feket663/raspiradio/Images/Audio_bord.jpg

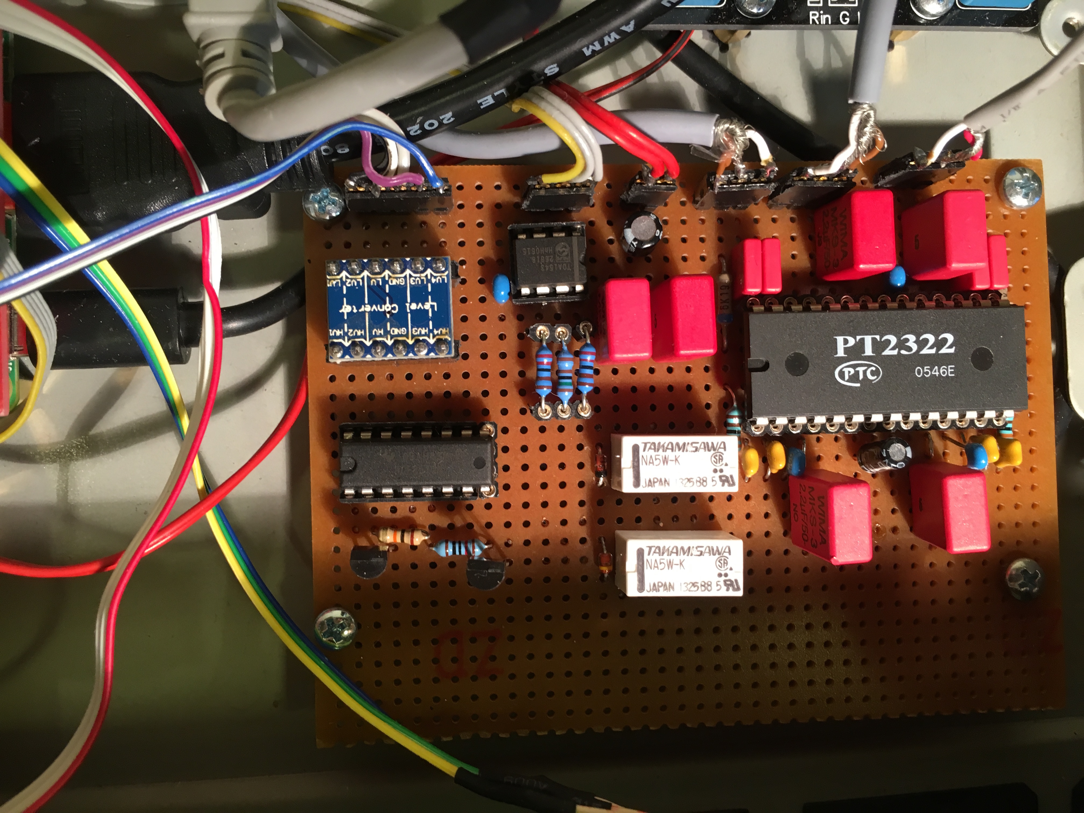
Images/Audio_bord.jpg
