feket663/raspiradio/Images/Client_open_back.jpg

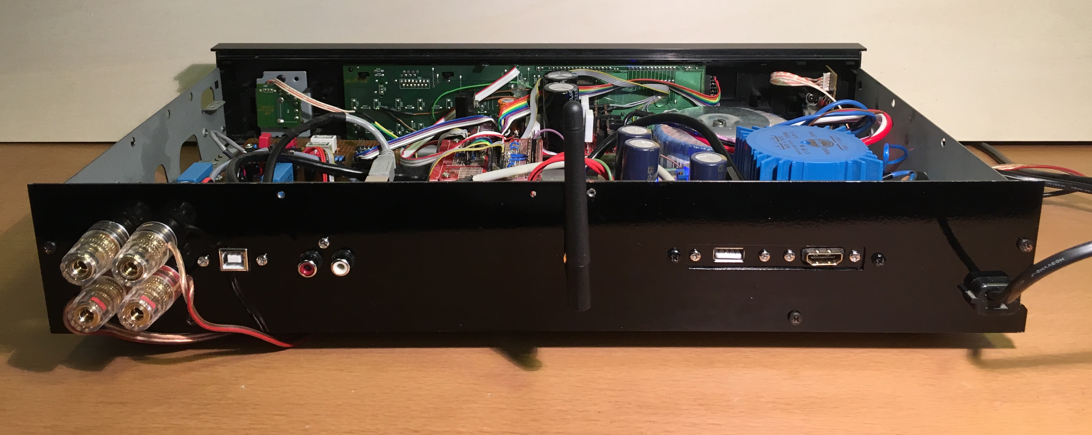
Images/Client_open_back.jpg
