feket663/raspiradio/Images/Client_open_front.jpg

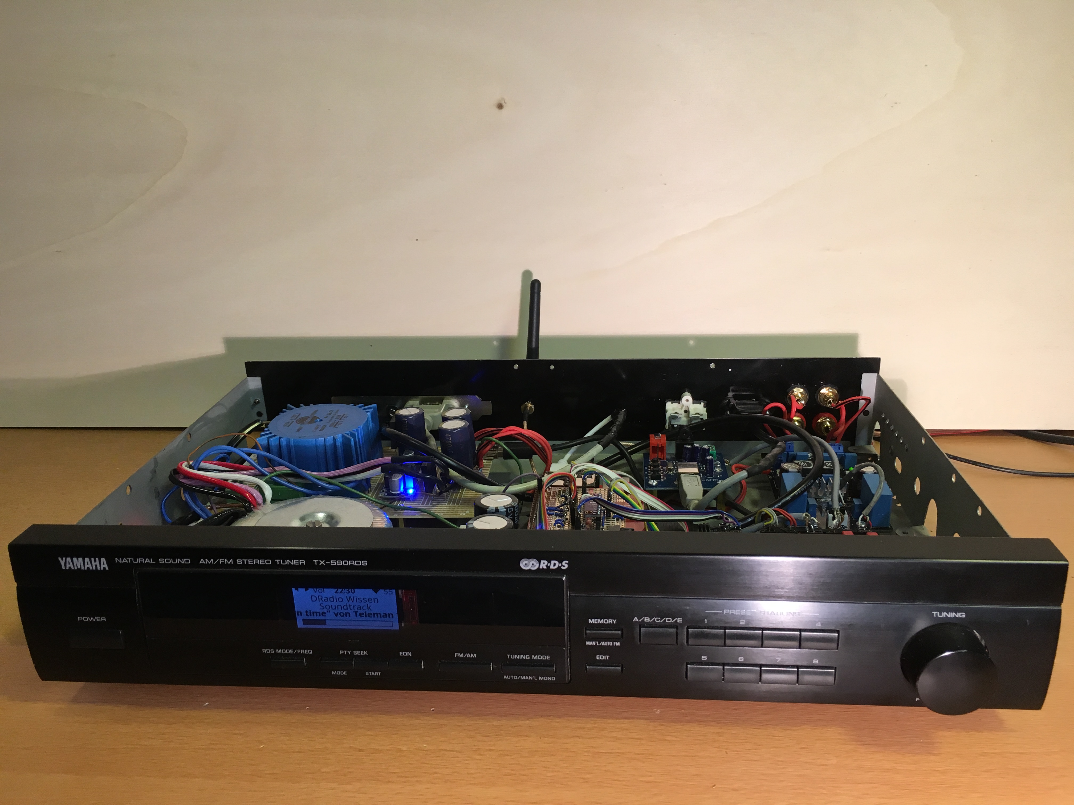
Images/Client_open_front.jpg
