feket663/raspiradio/Images/Client_open_top.jpg

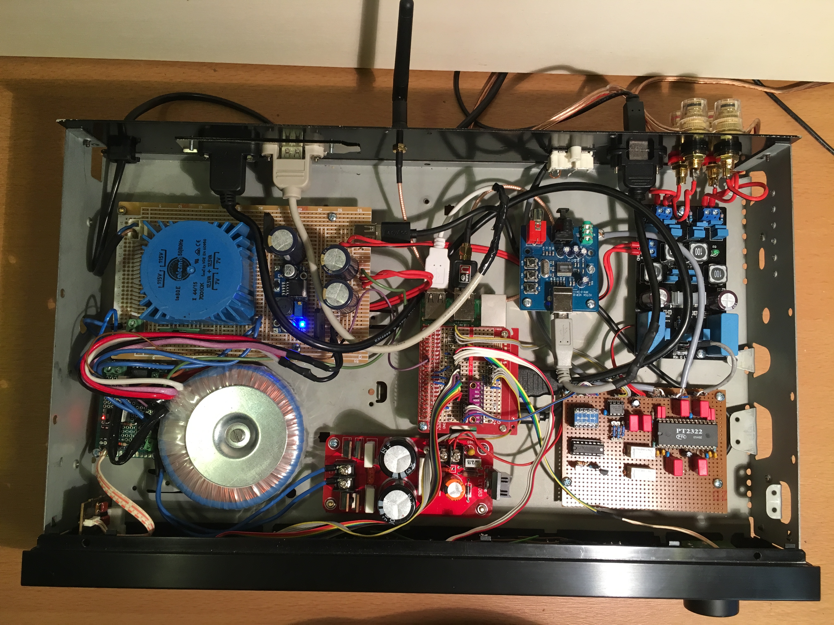
Images/Client_open_top.jpg
