feket663/raspiradio/Images/Client_without_speaker.jpg

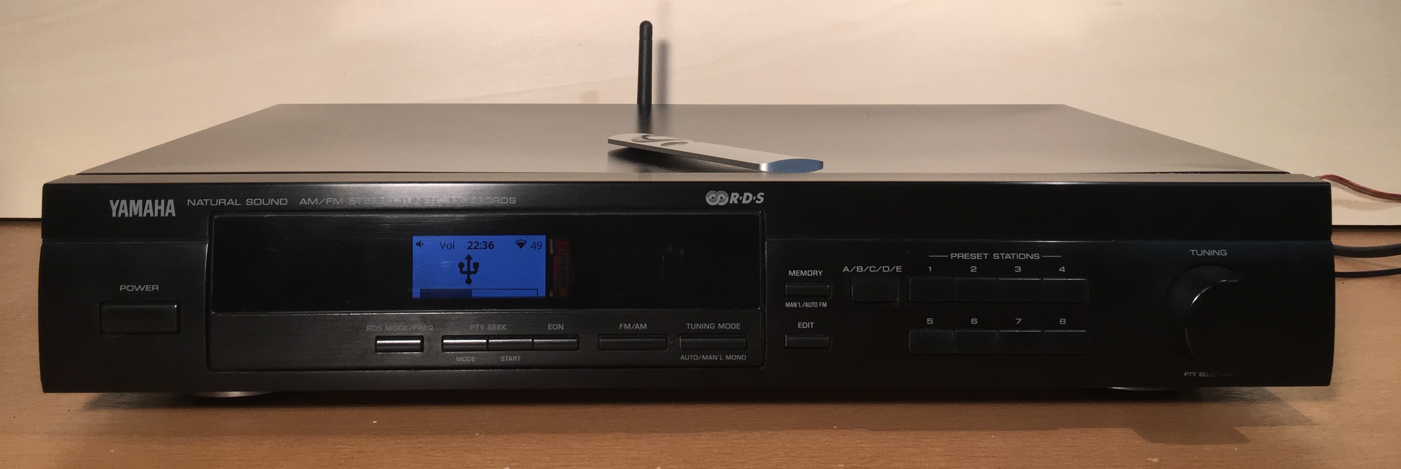
Images/Client_without_speaker.jpg
