feket663/raspiradio/Images/LOW-Noise-Power.jpeg

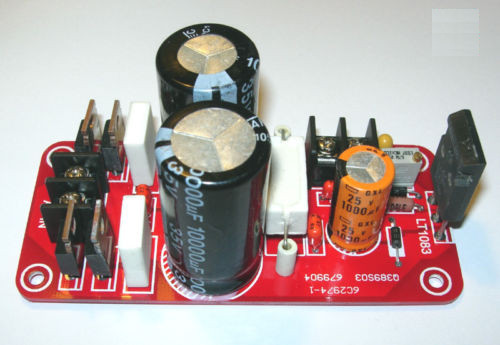
Images/LOW-Noise-Power.jpeg
