feket663/raspiradio/Images/low-power-schematics.jpeg

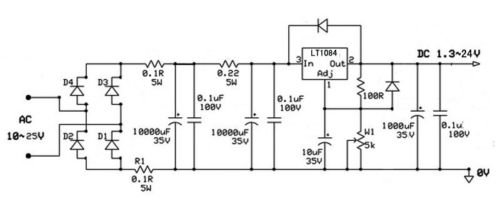
Images/low-power-schematics.jpeg
