feket663/raspiradio/Images/pcm2704_usb.jpg

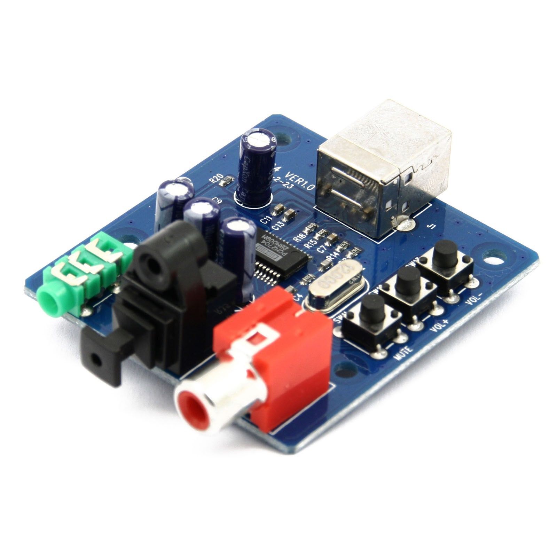
Images/pcm2704_usb.jpg
