feket663/raspiradio/Images/Power_control_board.jpg

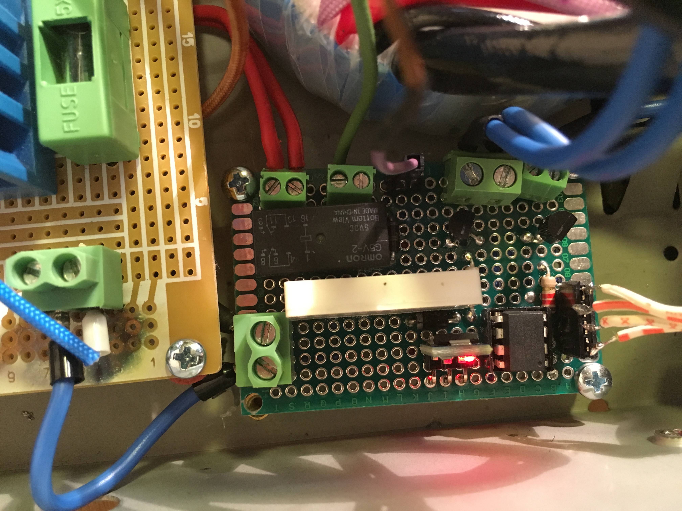
Images/Power_control_board.jpg
