feket663/raspiradio/Images/speaker_terminal.jpg

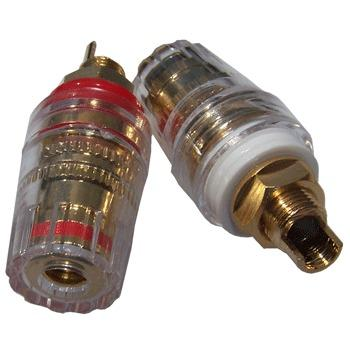
Images/speaker_terminal.jpg
