feket663/raspiradio/Images/TPA3116.jpg

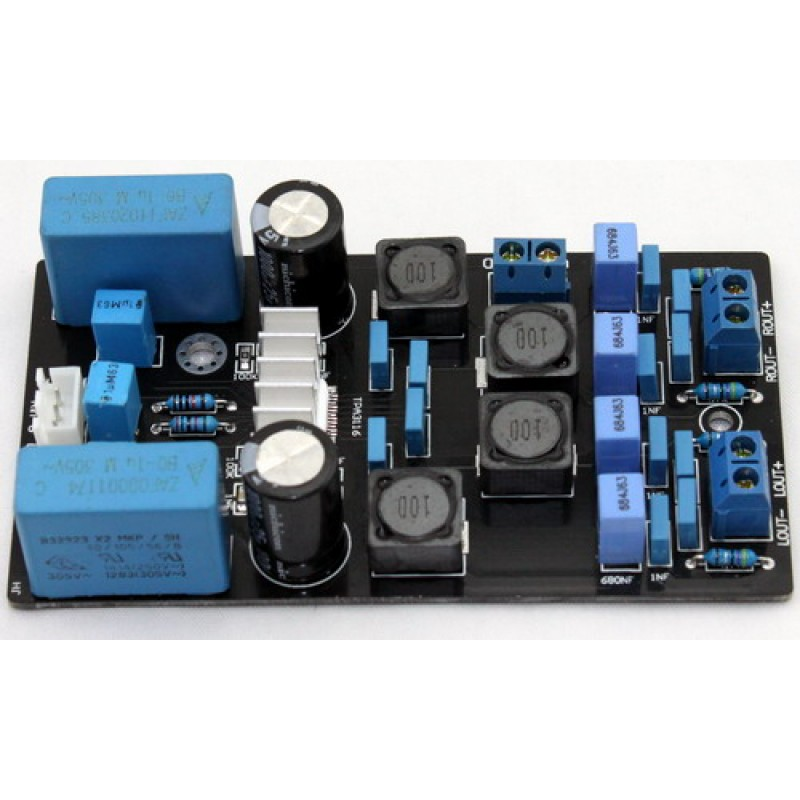
Images/TPA3116.jpg
