feket663/raspiradio/schematics/audio-board.png

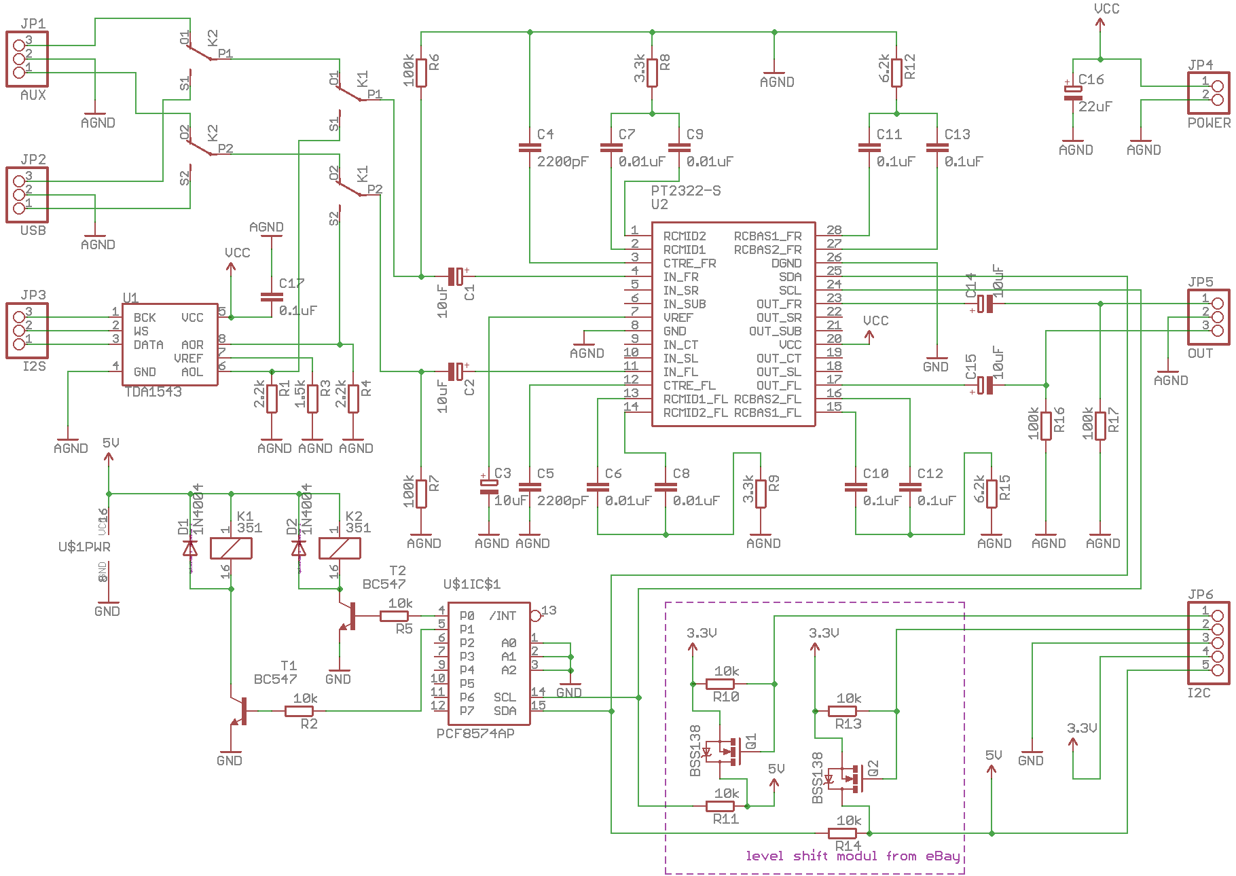
schematics/audio-board.png
