feket663/raspiradio/schematics/power-control-board.png

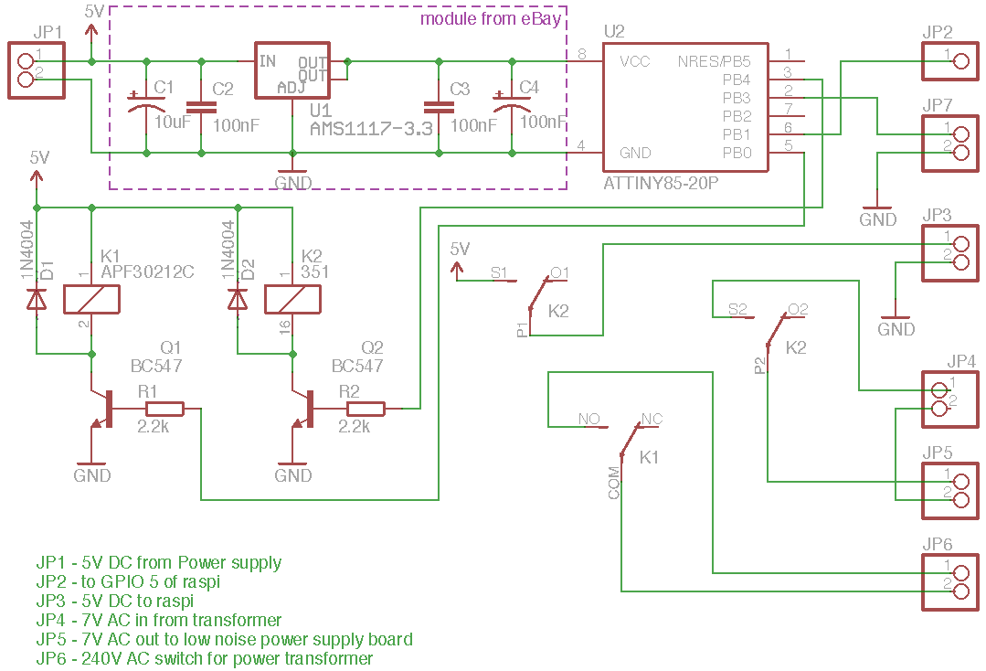
schematics/power-control-board.png
