feket663/raspiradio/schematics/audio-board.sch

## EAGLE design schematics/audio-board.sch (2016-09-04)

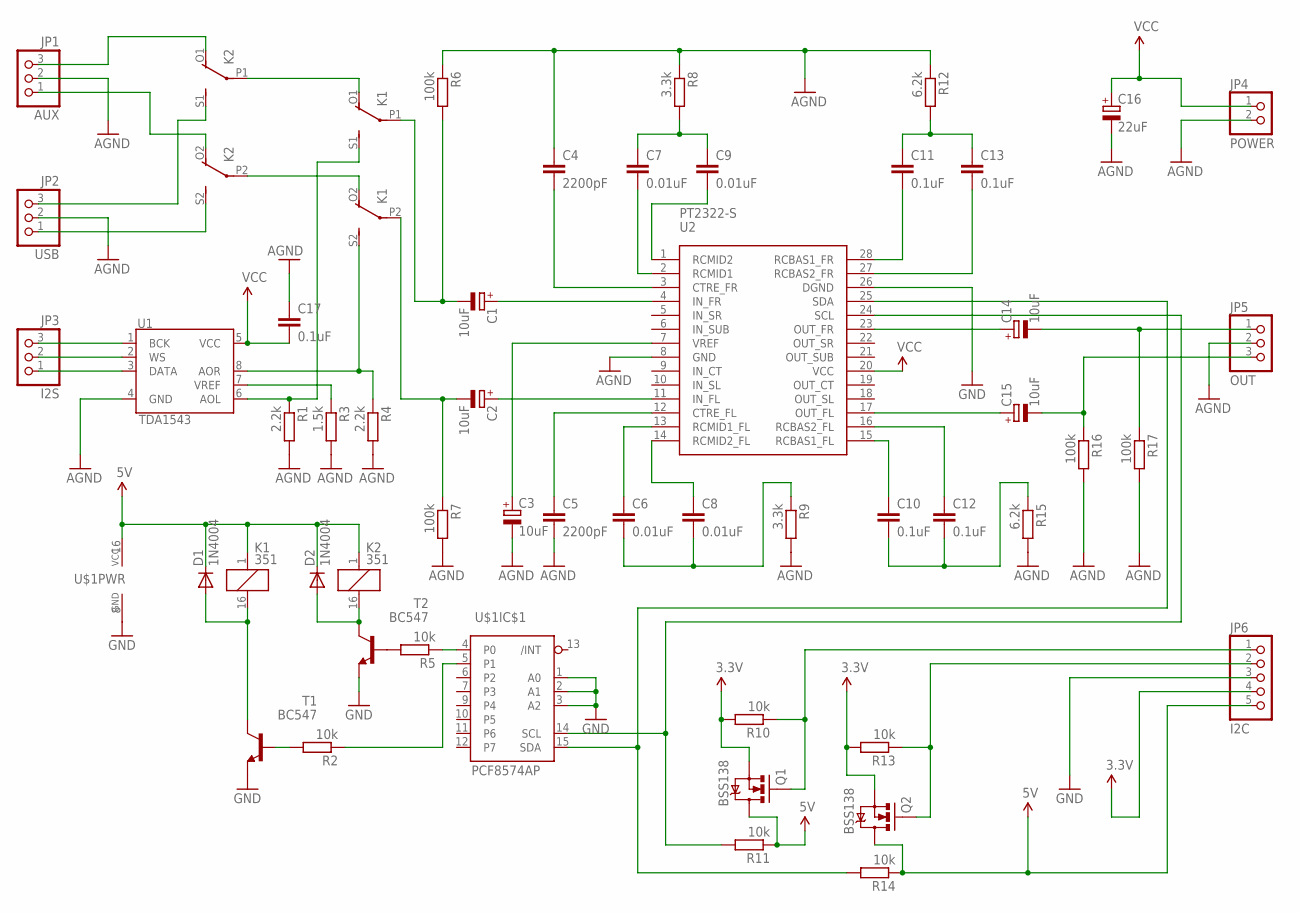
[picture p27: schematic audio-board.sch]

Parts:
AUX: JP1; 1X03
C1, C2, C3, C14, C15: 10uF; E2-5
C4, C5: 2200pF; C025-025X050
C6, C7, C8, C9: 0.01uF; C025-025X050
C10, C11, C12, C13, C17: 0.1uF; C025-025X050
C16: 22uF; E2,5-7
D1, D2: 1N4004; DO41-10
I2S: JP3; 1X03
JP4: POWER; 1X02
JP5: OUT; 1X03
JP6: I2C; 1X05
K1, K2: 351
Q1, Q2: BSS138; SOT23-3
R1, R4: 2.2k; 0207/10
R2, R5, R10, R11, R13, R14: 10k; 0207/10
R3: 1.5k; 0207/10
R6, R7, R16, R17: 100k; 0207/10
R8, R9: 3.3k; 0207/10
R12, R15: 6.2k; 0207/10
T1, T2: BC547; TO92
U1: TDA1543; DIL8
U2: PT2322-S; SOP28
U$1: PCF8574AP; DIL16
USB: JP2; 1X03

Connections:
3.3V: JP6.4, Q1.2 (S), Q2.2 (S), R10.2, R13.2
5V: D1.C, D2.C, JP6.5, K1.1, K2.1, Q1.3 (D), Q2.3 (D), R11.1, R14.1, U$1.16 (VCC)
AGND: AUX.2, C3.-, C4.1, C5.2, C16.-, C17.1, JP4.2, JP5.2, R1.2, R3.2, R4.2, R6.1, R7.2, R8.1, R9.2, R12.1, R15.2, R16.2, R17.2, U1.4 (GND), U2.8 (GND), USB.2
GND: JP6.3, T1.1 (E), T2.1 (E), U2.26 (DGND), U$1.1 (A0), U$1.2 (A1), U$1.3 (A2), U$1.8 (GND)
unnamed: C1.+, U2.4 (IN_FR)
unnamed: C2.+, U2.11 (IN_FL)
unnamed: C1.-, K1.P1, R6.2
unnamed: C2.-, K1.P2, R7.1
unnamed: C3.+, U2.7 (VREF)
unnamed: C5.1, U2.12 (CTRE_FL)
unnamed: C6.1, U2.13 (RCMID1_FL)
unnamed: C8.1, U2.14 (RCMID2_FL)
unnamed: C10.2, C12.2, R15.1
unnamed: C12.1, U2.16 (RCBAS2_FL)
unnamed: C10.1, U2.15 (RCBAS1_FL)
unnamed: K1.O1 (O), K2.P1
unnamed: C9.2, U2.1 (RCMID2)
unnamed: C7.2, U2.2 (RCMID1)
unnamed: C4.2, U2.3 (CTRE_FR)
unnamed: C7.1, C9.1, R8.2
unnamed: AUX.3, K2.O1 (O)
unnamed: C11.2, U2.28 (RCBAS1_FR)
unnamed: C13.2, U2.27 (RCBAS2_FR)
unnamed: C11.1, C13.1, R12.2
unnamed: C14.+, U2.23 (OUT_FR)
unnamed: C15.+, U2.17 (OUT_FL)
unnamed: C14.-, JP5.1, R17.1
unnamed: C15.-, JP5.3, R16.1
unnamed: AUX.1, K2.O2 (O)
unnamed: K2.S1 (S), USB.3
unnamed: K2.S2 (S), USB.1
unnamed: I2S.3, U1.1 (BCK)
unnamed: I2S.2, U1.2 (WS)
unnamed: I2S.1, U1.3 (DATA)
unnamed: K1.O2 (O), K2.P2
unnamed: D1.A, K1.16 (2), T1.3 (C)
unnamed: K1.S2 (S), R4.1, U1.8 (AOR)
unnamed: C6.2, C8.2, R9.1
unnamed: K1.S1 (S), R1.1, U1.6 (AOL)
unnamed: R3.1, U1.7 (VREF)
unnamed: D2.A, K2.16 (2), T2.3 (C)
unnamed: R5.2, T2.2 (B)
unnamed: R2.2, T1.2 (B)
unnamed: R11.2, U2.24 (SCL), U$1.14 (SCL)
unnamed: R14.2, U2.25 (SDA), U$1.15 (SDA)
unnamed: JP6.2, Q2.1 (G), R13.1
unnamed: JP6.1, Q1.1 (G), R10.1
U2: R5.1, U$1.4 (P0)
U3: R2.1, U$1.5 (P1)
VCC: C16.+, C17.2, JP4.1, U1.5 (VCC), U2.20 (VCC)
