feket663/raspiradio/schematics/power-control-board.sch

## EAGLE design schematics/power-control-board.sch (2016-09-01)

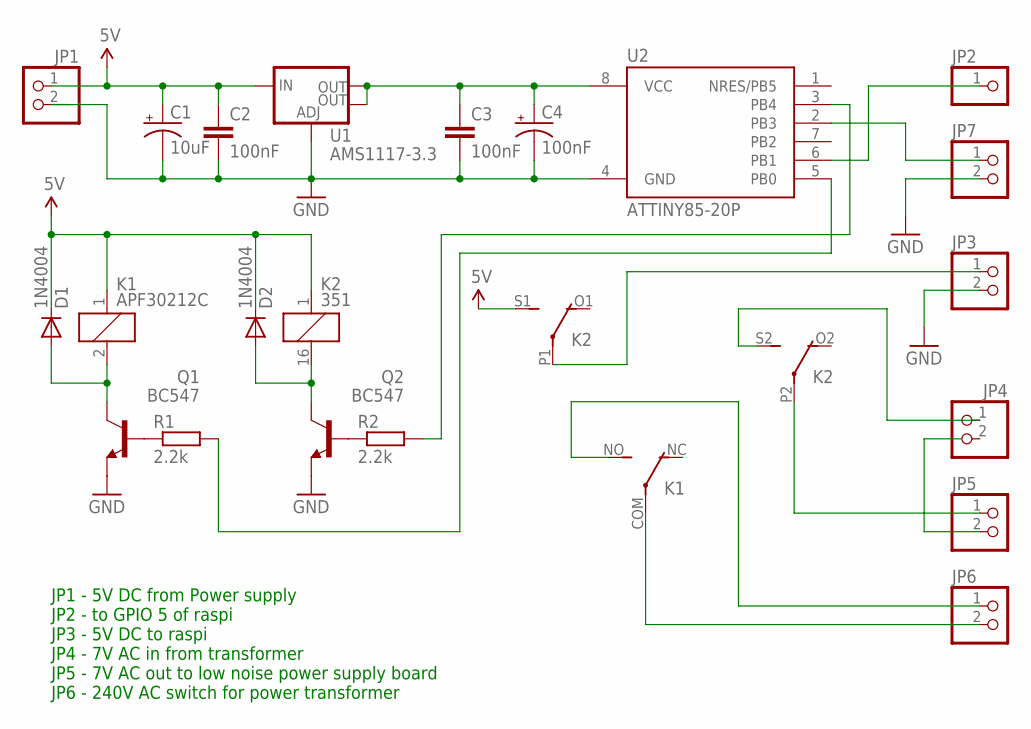
[picture p28: schematic power-control-board.sch]

Parts:
C1: 10uF; CPOL-RADIAL-10UF-25V-KIT
C2, C3: 100nF; 0402-CAP
C4: 100nF; CPOL-RADIAL-10UF-25V-KIT
D1, D2: 1N4004; DO41-10
JP1, JP3, JP4, JP5, JP6, JP7: PINHD-1X2; 1X02
JP2: PINHD-1X1; 1X01
K1: APF30212C
K2: 351
Q1, Q2: BC547; TO92
R1, R2: 2.2k; 0204/7
U1: AMS1117-3.3; SOT223
U2: ATTINY85-20P; PDIP08_300MIL

Connections:
5V: C1.1 (+), C2.1, D1.C, D2.C, JP1.1, K1.1, K2.1, K2.S1 (S), U1.3 (IN)
GND: C1.2 (-), C2.2, C3.2, C4.2 (-), JP1.2, JP3.2, JP7.2, Q1.1 (E), Q2.1 (E), U1.1 (ADJ), U2.4 (GND)
unnamed: Q1.2 (B), R1.1
unnamed: R1.2, U2.5 (PB0)
unnamed: R2.2, U2.3 (PB4)
unnamed: C3.1, C4.1 (+), U1.2 (OUT), U1.4 (OUT), U2.8 (VCC)
unnamed: D1.A, K1.2, Q1.3 (C)
unnamed: JP2.1, U2.6 (PB1)
unnamed: JP3.1, K2.P1
unnamed: Q2.2 (B), R2.1
unnamed: D2.A, K2.16 (2), Q2.3 (C)
unnamed: JP4.1, K2.S2 (S)
unnamed: JP5.1, K2.P2
unnamed: JP6.1, K1.NO (S)
unnamed: JP6.2, K1.COM
unnamed: JP7.1, U2.2 (PB3)

Notes on the sheet:
JP1 - 5V DC from Power supply JP2 - to GPIO 5 of raspi JP3 - 5V DC to raspi JP4 - 7V AC in from transformer JP5 - 7V AC out to low noise power supply board JP6 - 240V AC switch for power transformer
