feket663/raspiradio/schematics/power-supply-board.sch

## EAGLE design schematics/power-supply-board.sch (2016-09-01)

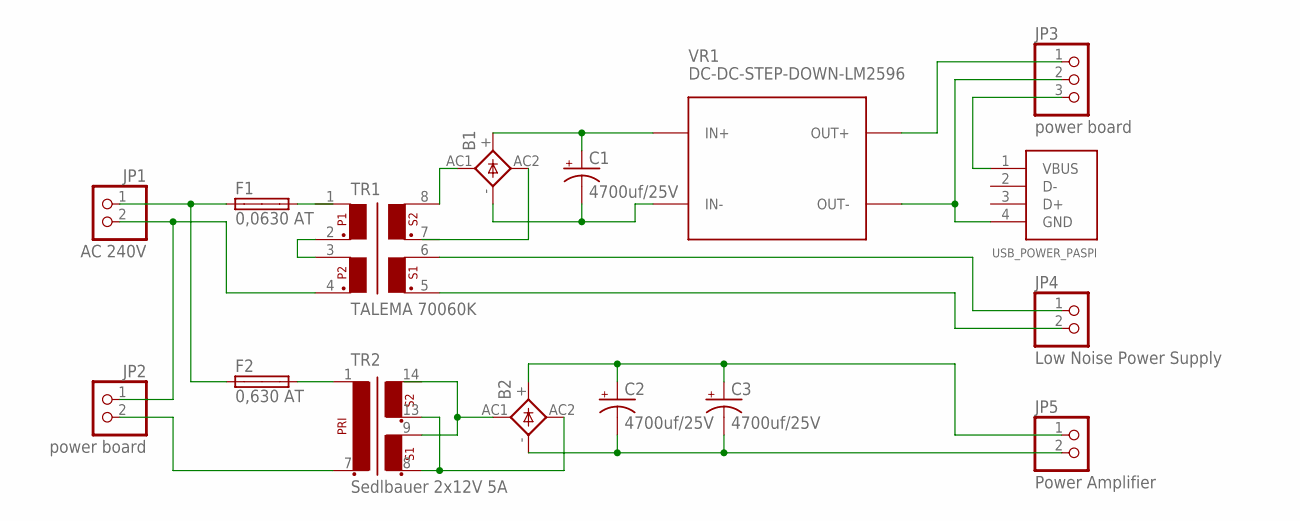
[picture p29: schematic power-supply-board.sch]

Parts:
B1, B2: KBU
C1, C2, C3: 4700uf/25V; CPOL-RADIAL-1000UF-25V-KIT
F1: 0,0630 AT; SHK20L
F2: 0,630 AT; SHK20L
JP1: AC 240V; 1X02
JP2: power board; 1X02
JP3: power board; 1X03
JP4: Low Noise Power Supply; 1X02
JP5: Power Amplifier; 1X02
TR1: TALEMA 70060K; FL10-30
TR2: Sedlbauer 2x12V 5A; EI54-18,8_16VA
USB_POWER_PASPI: USB POWER RASPI; USB-MALE-A-PCB
VR1: DC-DC-STEP-DOWN-LM2596

Connections:
unnamed: F2.2A, TR2.1
unnamed: TR1.2, TR1.3
unnamed: B2.AC2, TR2.8 (3), TR2.13 (5)
unnamed: B2.AC1, TR2.9 (4)
unnamed: B1.AC1, TR1.8
unnamed: B1.+, C1.+, VR1.IN+
unnamed: B1.-, C1.-, VR1.IN-
unnamed: JP3.1, VR1.OUT+
unnamed: JP4.1, TR1.6
unnamed: JP4.2, TR1.5
unnamed: JP3.2, USB_POWER_PASPI.4 (GND), VR1.OUT-
unnamed: F1.1A, F2.1A, JP1.1
unnamed: JP3.3, USB_POWER_PASPI.1 (VBUS)
unnamed: JP1.2, JP2.1, TR1.4
unnamed: B2.+, C2.+, C3.+, JP5.1
unnamed: B2.-, C2.-, C3.-, JP5.2
unnamed: JP2.2, TR2.7 (2)
