feket663/raspiradio/Images/Power_supply_board.jpg

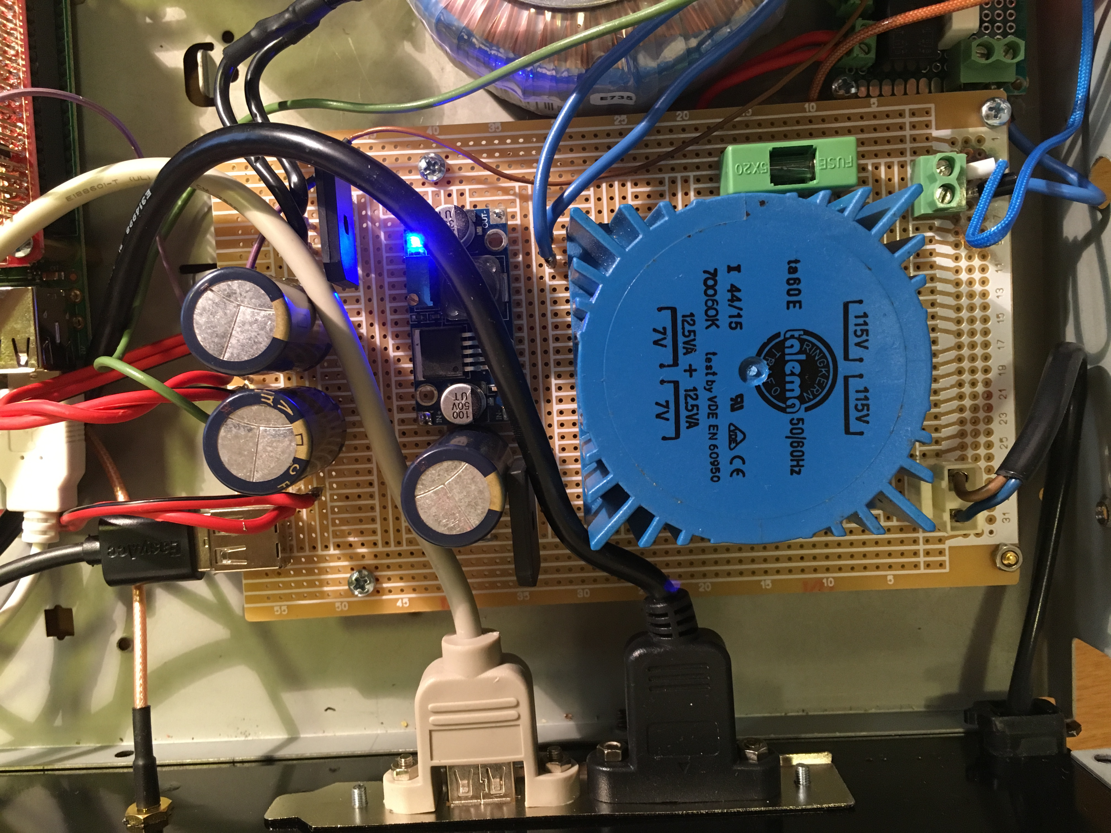
Images/Power_supply_board.jpg
